VE3QVY/twotonegenerator/README.md

# Simple Two Tone Generator

The quick brown fox jumps over the lazy dog's back.  Now is the time for all good men to come to the aid of the country.

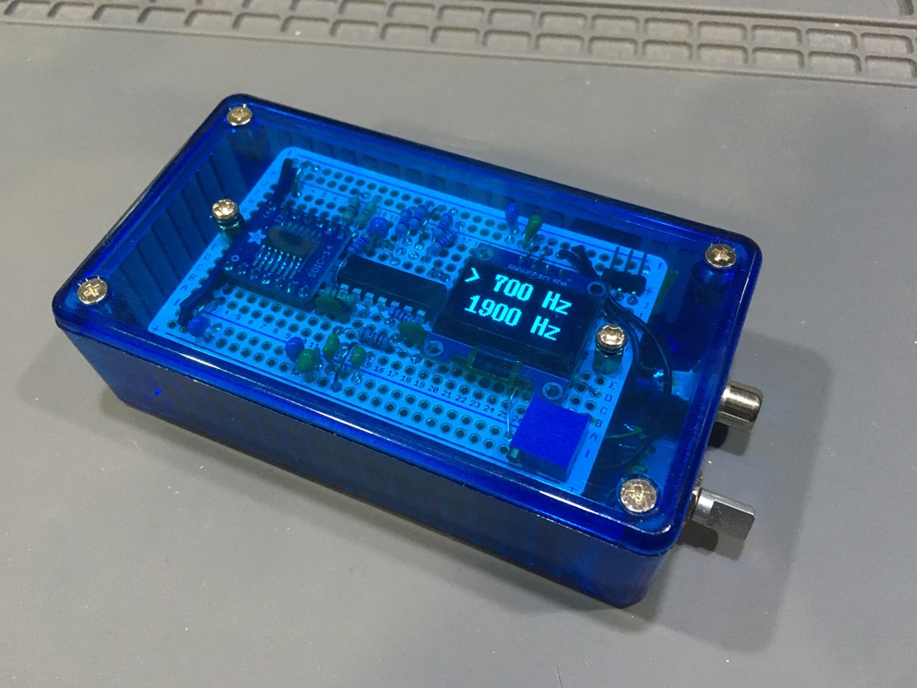
[picture p1: twotone1.jpg]
Completed Two Tone Generator
