VE3QVY/twotonegenerator/twotone2.jpg

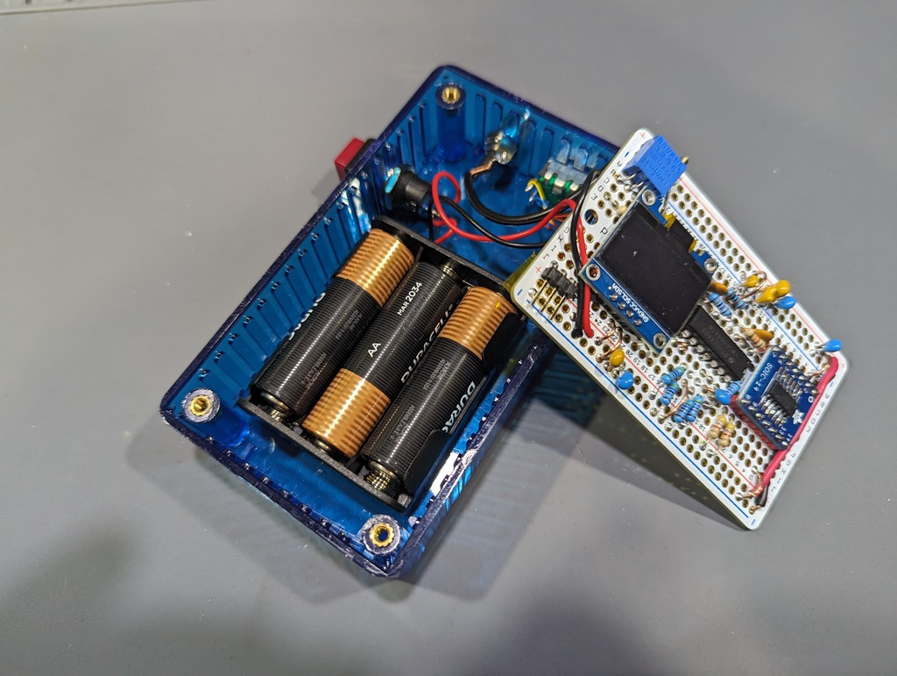
twotone2.jpg
