VE3QVY/twotonegenerator/twotonegenerator.png

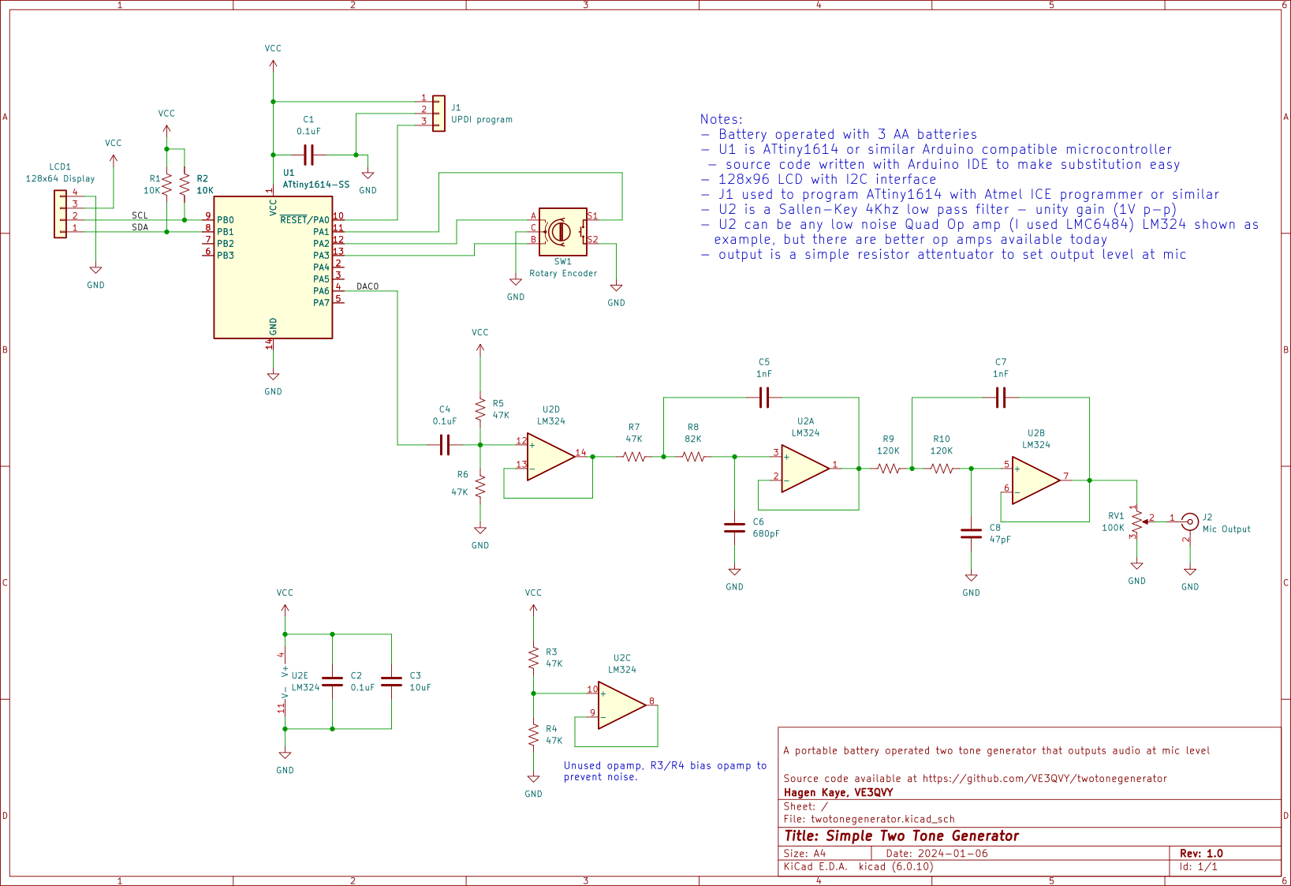
twotonegenerator.png
