VE3QVY/twotonegenerator/(commit log)

2024-01-06 added schematics in png and pdf format
2024-01-06 reset phase when frequecy is changed
    [twotonegenerator.ino]
